linenoise/synferno/docs/diagrams/Synferno Block Diagram.graffle/image1.png

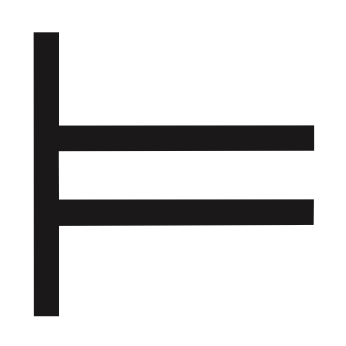
docs/diagrams/Synferno Block Diagram.graffle/image1.png
