linenoise/synferno/src/Synferno_15/Button.h

#ifndef Button_h
#define Button_h

#include <Arduino.h>

#include <Metro.h>

// pins
#define BUTTON_PIN1 7
#define BUTTON_PIN2 12

class Button{
  public:
    void begin(byte pin, boolean pressedValue=LOW);

    boolean update();

    byte getState();
    
  private:
    byte pressedValue, currentState, pin;
};

#endif
