linenoise/synferno/(commit log)

2017-04-03 Adding block diagram and Bill of Materials
2017-04-03 Swapping Bill of Materials and Console Layout
2017-04-04 Linking to AmpliFire codebase, adding flame effect BOM
2017-04-04 Setting arm and fire LED statuses correctly
    [Synferno.ino]
2017-04-04 Moving to SoftwareSerial and Arduino Uno
2017-04-05 Adding 12V power supply, power rail, and diodes to protect relay from VSWR
2017-04-05 Moving calibration pot to be next to the flame effect connectors
2017-04-05 Moving flame effect diodes
2017-04-05 Moving to 1N4001 diodes for 12v power rail feedback protection
2017-04-06 Updating block diagram to run power rail through keylock
2017-07-24 imposed a hardware level lockout on solenoid state change
2017-08-08 Updating Bill of Materials
2018-08-15 added momentary pushbutton which resets the midi clock counter on when pressed
    [Button.h, MIDI.cpp, MIDI.h, Synferno_15.ino]
